perkinsb1024/Block_M_Pin/PCB/Block M.brd

## EAGLE design PCB/Block M.brd (2018-08-06)

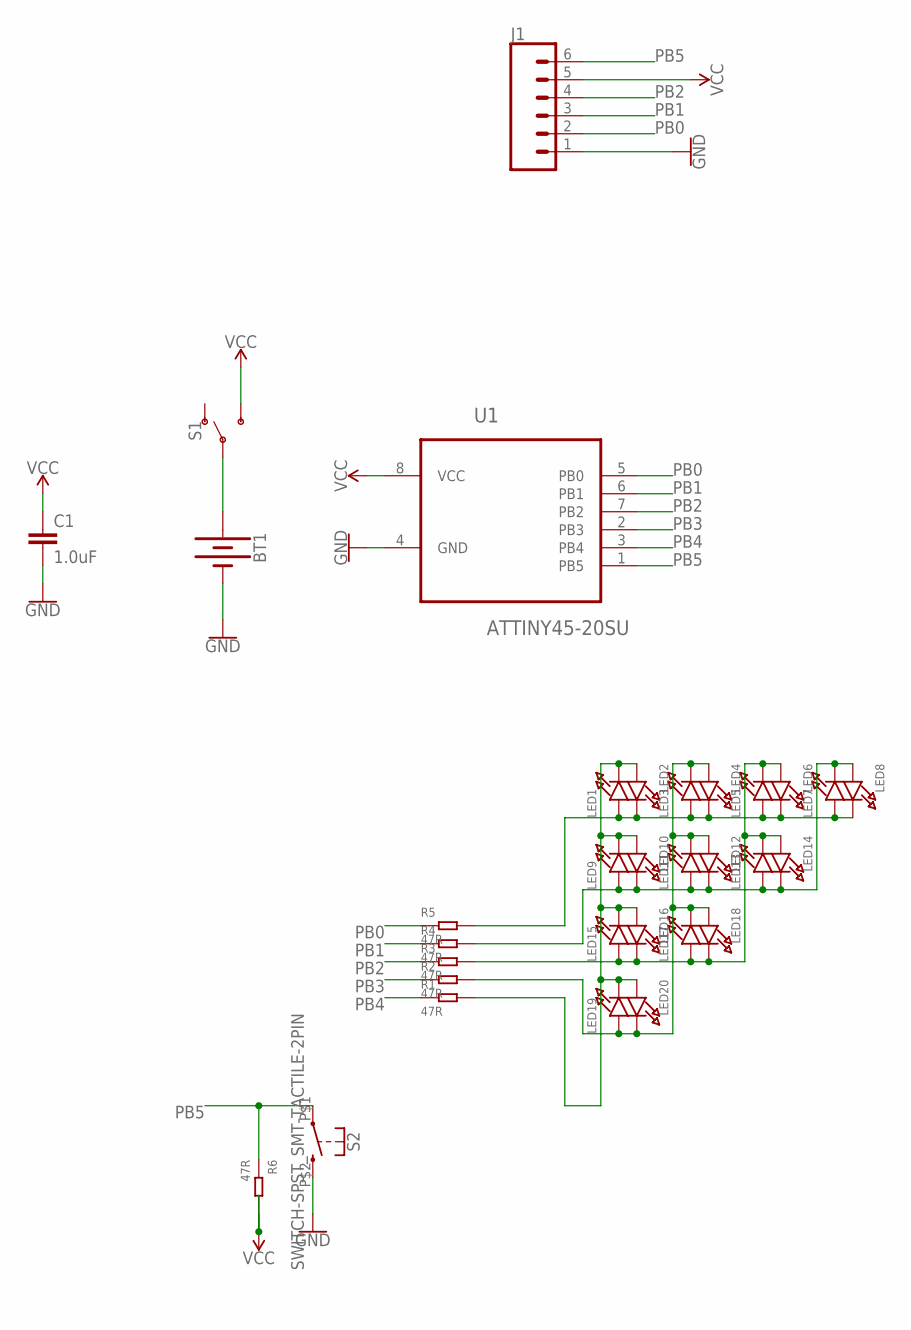
[picture p1: schematic Block M.sch]

Parts:
BT1: BATTERY-12MM_SMD_ALT; BATTCON_12MM_ALT
C1: 1.0uF; 0805
J1: CONN_06SMD-FEMALE-NO-SILK; 1X06-SMD-FEMALE_NO_SILK
LED1, LED2, LED3, LED4, LED5, LED6, LED7, LED8, LED9, LED10, LED11, LED12, LED13, LED14, LED15, LED16, LED17, LED18, LED19, LED20: LED0805_NOOUTLINE; CHIPLED_0805_NOOUTLINE
R1, R2, R3, R4, R5, R6: 47R; R0805
S1: SWITCH-SPDT-SMD-RIGHT-ANGLE; SWITCH_SPST_SMD_A
S2: SWITCH-SPST_SMT-TACTILE-2PIN; SMT_TACTILE_SWITCH_3X2MM
U1: ATTINY45-20SU; SOIC127P798X216-8N

Connections:
GND: BT1.GND (-), C1.2, J1.1, S2.P$2 (2), U1.4 (GND)
unnamed: LED1.A, LED2.C, LED3.A, LED4.C, LED5.A, LED6.C, LED7.A, LED8.C, R5.2
unnamed: BT1.PWR@2 (+), S1.2
unnamed: LED3.C, LED4.A, LED11.C, LED12.A, LED17.C, LED18.A, LED19.A, LED20.C, R2.2
unnamed: LED5.C, LED6.A, LED13.C, LED14.A, LED15.A, LED16.C, LED17.A, LED18.C, R3.2
unnamed: LED1.C, LED2.A, LED9.C, LED10.A, LED15.C, LED16.A, LED19.C, LED20.A, R1.2
unnamed: LED7.C, LED8.A, LED9.A, LED10.C, LED11.A, LED12.C, LED13.A, LED14.C, R4.2
PB0: J1.2, R5.1, U1.5 (PB0)
PB1: J1.3, R4.1, U1.6 (PB1)
PB2: J1.4, R3.1, U1.7 (PB2)
PB3: R2.1, U1.2 (PB3)
PB4: R1.1, U1.3 (PB4)
PB5: J1.6, R6.1, S2.P$1 (1), U1.1 (PB5)
VCC: C1.1, J1.5, R6.2, S1.3 (S), U1.8 (VCC)

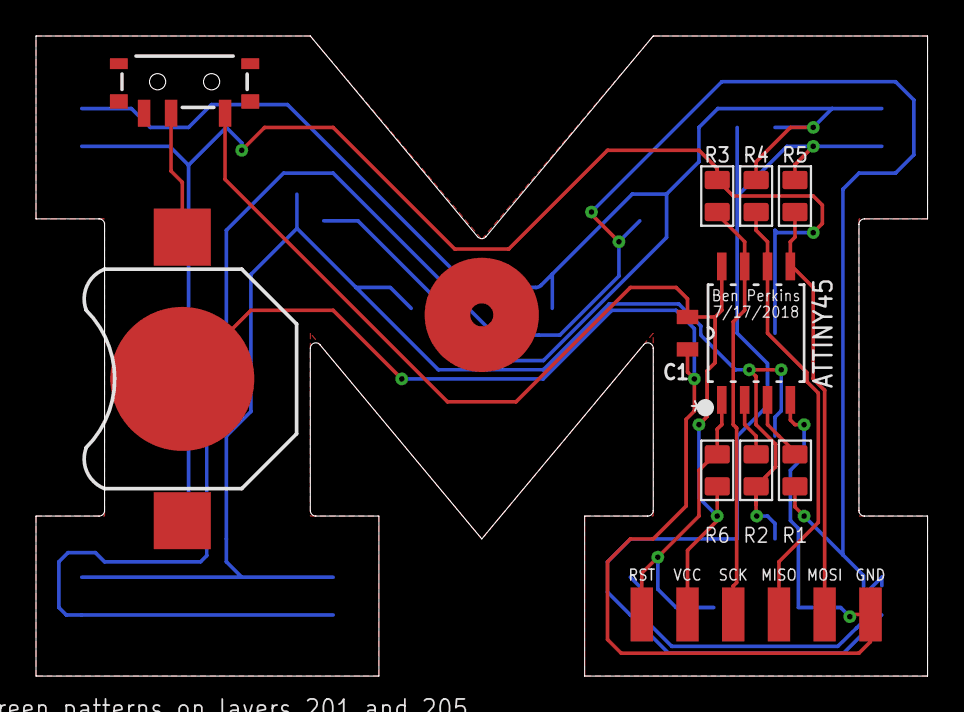
[picture p2: board Block M.brd from above]

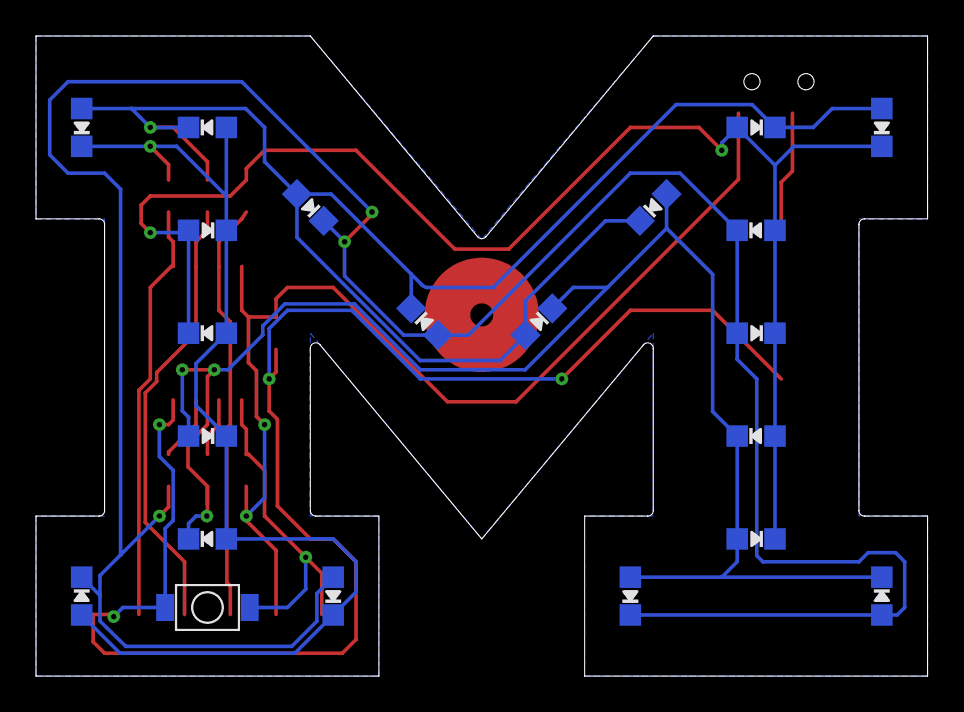
[picture p3: board Block M.brd from below]

Board: 2 copper layers, 49.5 x 35.6 mm, 32 parts (21 on the bottom side), 14 nets.
