perkinsb1024/Block_M_Pin/Block_M/Block_M.ino

// For more information, visit:
// http://bitwise.bperki.com/2018/08/05/block-m-pin-update-2-software-power-and-videos/

// Program configuration
#define USE_EEPROM true

#if USE_EEPROM
#include <EEPROM.h>
#endif

// Limits
#define MAX_DELAY (65535)
#define NUM_LEDS (20)
#define NUM_PATTERNS (7)
#define MIN_RAND_A (96)
#define MAX_RAND_A (138)

// References
#define EEPROM_ADDR_PATTERN (0)
#define EEPROM_ADDR_RAND_A (1)

// Keep track of which pattern to display.
uint8_t patternIndex = 0;
// Keep track of whether the reset reason was the power switch or reset button.
uint8_t buttonPressed = 0;
// This is one of two seed values for the random function.
uint8_t a = MIN_RAND_A;
// This array stores the pin states to light up each LED.
// The high nibble determines which pin number should be high.
// The low nibble defines which pin should be low. All other pins
// should be high impedence (input).
const uint8_t LEDS[] = {
  // High pin - 1 | Low Pin - 1
  0x00 | 0xF, // Bottom left, outer   
  0xF0 | 0x0, // Bottom left, inner
  0x00 | 0x7, // Left straight, 1/5
  0x70 | 0x0, // Left straight, 2/5
  0x00 | 0x3, // Left straight, 3/5
  0x30 | 0x0, // Left straight, 4/5
  0x10 | 0x0, // Top left
  0x00 | 0x1, // Left straight, 5/5
  0x10 | 0xF, // Top left slope
  0xF0 | 0x1, // Bottom left slope
  0x10 | 0x7, // Bottom right slope
  0x70 | 0x1, // Top right slope
  0x30 | 0x1, // Right straight 5/5
  0x10 | 0x3, // Top right
  0x30 | 0xF, // Right straight 4/5
  0xF0 | 0x3, // Right straight 3/5
  0x30 | 0x7, // Right straight 2/5
  0x70 | 0x3, // Right straight 1/5
  0x70 | 0xF, // Bottom right, inner
  0xF0 | 0x7, // Bottom right, outer
  0x00 | 0x0, // No LEDs
}; 

/*
 * Function:  delayCycles 
 * --------------------
 * Delays for a given number of cycles.
 *
 * n: number of cycles to wait.
 */
void delayCycles(uint16_t n) {
  while(n--) {
    asm("nop");
  }
}

/*
 * Function:  pRNG
 * --------------------
 * Generates a "random" number.
 *
 * returns: a somewhat random number.
 */
uint8_t pRNG(void) {
  // https://www.avrfreaks.net/forum/tiny-fast-prng
  // Note: `a` is defined globally, read from EEPROM for improved 'randomness'
  static uint8_t s=0x0F;
  s^=s<<3;
  s^=s>>5;
  s^=a++>>2;
  return s;
}

/*
 * Function:  setLed 
 * --------------------
 * Light a single LED.
 *
 * led: which LED to light (0 to NUM_LEDS-1).
 */
void setLed(uint8_t led) {
  led = LEDS[led];
  uint8_t high = ((led & 0xF0) >> 4) + 1;
  uint8_t low = (led & 0x0F) + 1;
  charlieplex(high, low);
}

/*
 * Function:  charlieplex 
 * --------------------
 * Light a single LED
 *
 * high: the PORTB pin value that should be high.
 * low: the PORTB pin value that should be low.
 */
void charlieplex(uint8_t high, uint8_t low) {
  DDRB = high | low;
  PORTB = high;
}

/*
 * Function:  clearAll 
 * --------------------
 * Turns off all LEDs.
 */
inline void clearAll() {
  DDRB = 0;
  PORTB = 0;
}

/*
 * Function:  drawBitmap
 * --------------------
 * Light LEDs based on a values in a bitmap.
 * Should be called in a loop.
 *
 * bitmap: bit n represents LED n, 1 = on, 0 = off.
 */
void drawBitmap(uint32_t bitmap) {
  // Shift bitmap right one bit at a time to determine if each LED should be on
  for(uint8_t i = 0; i < NUM_LEDS; i++) {
    if(bitmap & 1) {
      // Turn on the current LED
      setLed(i);
    }
    else {
      // Displays nothing, but takes the same amount of time
      // to keep the brightness equal regardless of how many LEDs are on
      setLed(NUM_LEDS);
    }
    // Shift right to get the next pixel
    bitmap = bitmap >> 1;
  }
}

/*
 * Function:  drawBitmapFast
 * --------------------
 * Light LEDs based on a values in a bitmap.
 * Should be called in a loop.
 * Like drawBitmap, but faster. Brightness of LEDs will vary.
 *
 * bitmap: bit n represents LED n, 1 = on, 0 = off.
 */
void drawBitmapFast(uint32_t bitmap) {
  // The brightness of LEDs will change based on how many are lighted
  // Shift bitmap right one bit at a time to determine if each LED should be on
  for(uint8_t i = 0; i < NUM_LEDS; i++) {
    if(bitmap & 1) {
      // Turn on the current LED
      setLed(i);
    }
    // Shift right to get the next pixel
    bitmap = bitmap >> 1;
  }
}

/*
 * Function:  patternSingleBlink
 * --------------------
 * LEDs blink randomly, one at a time.
 * Should be called in a loop.
 */
void patternSingleBlink() {
  uint8_t led = pRNG();
  uint16_t onTime = 8000 + 256 << (pRNG() & 0b111); // 8256 - 40768
  uint16_t offTime = 8000 + 256 << (pRNG() & 0b111); // 8256 - 40768
  // Intentionally allowing overflow by 1 to show no LEDs
  while(led > NUM_LEDS) {
    led -= NUM_LEDS;
  }
  setLed(led);
  delayCycles(onTime);
  clearAll();
  delayCycles(offTime);
}

/*
 * Function:  patternRandomNoise
 * --------------------
 * LEDs blink randomly, up to half of at a time.
 * Should be called in a loop.
 */
void patternRandomNoise() {
  // Only half the LEDs can possibly be on at a time, alternating every cycle.
  // This produces more "motion".
  uint32_t mask = 0x55555555;
  uint32_t oldBitmap = 0;
  uint32_t bitmap = 0;
  for(uint8_t i = 0; i < 255; i++) {
    bitmap = pRNG();
    bitmap <<= 8;
    bitmap |= pRNG();
    bitmap <<= 8;
    bitmap |= pRNG();
    bitmap ^= oldBitmap;
    mask = ~mask;
    for(uint16_t i = 0; i < 250; i++) {
      drawBitmapFast(bitmap & mask);
    }
  }
}

/*
 * Function:  patternFadingBlink
 * --------------------
 * LEDs blink randomly, fading out after turning on.
 * Should be called in a loop.
 */
void patternFadingBlink() {
  const uint8_t BRIGHTNESS_STEPS = 16;
  const uint8_t NUM_REPS = 4;
  const uint8_t NUM_DIFF_DELAYS = 8;
  uint8_t newLed;
  uint8_t leds[NUM_LEDS] = {0};
  uint8_t newLedDelays[NUM_DIFF_DELAYS] = {4, 5, 6, 7, 8, 10, 12, 16};
  uint8_t newLedDelay = newLedDelays[0];
  uint16_t newLedCounter = 0;
  uint8_t delayChanger = 0;
  uint8_t temp;
  while(1) {
    delayChanger = pRNG();
    if(delayChanger == 255) { return; }// Todo: remove
    if(delayChanger == newLedDelay) {
      temp = (pRNG() % NUM_DIFF_DELAYS);
      newLedDelay = newLedDelays[temp];
    }
    for(uint16_t rep = 0; rep < NUM_REPS; rep++) {
      newLedCounter++;
      if(newLedCounter >= newLedDelay) {
        newLedCounter = 0;
        newLed = pRNG() % 32;
        if(newLed < NUM_LEDS && leds[newLed] == 0) { 
          leds[newLed] = BRIGHTNESS_STEPS;
        }
      }
      for(uint8_t brightness = 0; brightness < BRIGHTNESS_STEPS; brightness++) {
        for(uint8_t led = 0; led < NUM_LEDS; led++) {
          if(leds[led] > 0) {
            if(leds[led] > brightness) { setLed(led); }
            else { clearAll(); }
          }
        }
      }
    }
    for(uint8_t led = 0; led < NUM_LEDS; led++) {
      if(leds[led] > 0) {
        leds[led]--;
      }
    }
  }
}

/*
 * Function:  patternBoomIn
 * --------------------
 * Like a VU/Volume Meter.
 * Should be called in a loop followed by patternBoomOut.
 * 
 * leds: array of uint8_t of size NUM_LEDS, init with 0 outside of loop.
 */
void patternBoomIn(uint8_t* leds) {
  const uint8_t BRIGHTNESS_STEPS = 32;
  const uint8_t BRIGHTNESS_STEP = 17;
  const uint8_t NUM_REPS = 1 + (pRNG() & 1);
  const uint8_t MAX_STAGES = 10;
  uint8_t centerStages[NUM_LEDS] = {10, 4, 8, 6, 4, 6, 10, 8, 4, 1, 1, 4, 8, 10, 6, 4, 6, 8, 4, 10};
  uint8_t chaseStages[NUM_LEDS] = {8, 8, 7, 6, 5, 4, 4, 3, 2, 1, 1, 2, 3, 4, 4, 5, 6, 7, 8, 8};
  uint8_t verticalStages[NUM_LEDS] = {1, 1, 2, 3, 4, 5, 6, 6, 5, 4, 4, 5, 6, 6, 5, 4, 3, 2, 1, 1};
  uint8_t stage = 0;
  uint8_t offDelay = 0;
  bool done = false;
  bool doneEarly = false;
  while(!(done || doneEarly)) {
    // Light the LEDs proportional to the value at leds[i].
    for(uint16_t rep = 0; rep < NUM_REPS; rep++) {
      for(uint8_t brightness = 0; brightness < BRIGHTNESS_STEPS; brightness++) {
        for(uint8_t led = 0; led < NUM_LEDS; led++) {
            if(leds[led] > brightness) { setLed(led); }
            else { clearAll(); }
        }
      }
    }
    // Adjust brightness of each led.
    done = true;
    if(stage < MAX_STAGES) { stage++; }
    for(uint8_t led = 0; led < NUM_LEDS; led++) {
      if(leds[led] < BRIGHTNESS_STEPS) {
        if(stage >= verticalStages[led]) {
          leds[led] += 8;
        }
        done = false;
      }
      else {
        leds[led] = BRIGHTNESS_STEPS;
      }
    }
    if(pRNG() < 20) { doneEarly = true; }
  }
}

/*
 * Function:  patternBoomOut
 * --------------------
 * Like a VU/Volume Meter.
 * Should be called in a loop preceded by patternBoomIn.
 * 
 * leds: array of uint8_t of size NUM_LEDS, same array
 *       as passed into patternBoomIn.
 */
void patternBoomOut(uint8_t* leds) {
  const uint8_t BRIGHTNESS_STEPS = 32;
  const uint8_t NUM_REPS = 2;
  uint8_t centerFade[NUM_LEDS] = {8, 4, 7, 6, 3, 6, 8, 7, 2, 1, 1, 2, 7, 8, 6, 3, 6, 7, 4, 8};
  uint8_t chaseFade[NUM_LEDS] = {8, 8, 7, 6, 5, 4, 4, 3, 2, 1, 1, 2, 3, 4, 4, 5, 6, 7, 8, 8};
//  uint8_t verticalFade[NUM_LEDS] = {1, 1, 2, 3, 4, 5, 6, 6, 5, 4, 4, 5, 6, 6, 5, 4, 3, 2, 1, 1};
  uint8_t verticalFade[NUM_LEDS] = {2, 2, 4, 6, 8, 10, 12, 12, 10, 8, 8, 10, 12, 12, 10, 8, 6, 4, 2, 2};
  uint8_t offDelay = 0;
  bool done = false;
  bool doneEarly = false;
  for(uint8_t led = 0; led < NUM_LEDS; led++) {
    leds[led] = BRIGHTNESS_STEPS;
  }
  while(!(done || doneEarly)) {
    // Light the LEDs proportional to the value at leds[i].
    for(uint16_t rep = 0; rep < NUM_REPS; rep++) {
      for(uint8_t brightness = 0; brightness < BRIGHTNESS_STEPS; brightness++) {
        for(uint8_t led = 0; led < NUM_LEDS; led++) {
            if(leds[led] > brightness) { setLed(led); }
            else { clearAll(); }
        }
      }
    }
    // Adjust brightness of each led
    done = true;
    for(uint8_t led = 0; led < NUM_LEDS; led++) {
      if(leds[led] > verticalFade[led]) {
        leds[led] -= verticalFade[led];
        done = false;
      }
      else {
        leds[led] = 0;
      }
    }
    if(pRNG() < 24) { doneEarly = true; }
  }
  if(done) {
    clearAll();
    offDelay = pRNG();
    if(offDelay & 1) {
      while(offDelay > 0) {
        delayCycles(150);
        offDelay--;
      }
    }
  }
}

/*
 * Function:  patternLoop
 * --------------------
 * LEDs fill up one at a time before unfilling one at a time.
 * Should be called in a loop.
 */
void patternLoop() {
  uint32_t bitmap = 0;
  for(uint8_t j = 0; j <= NUM_LEDS * 2; j++) {
    for(uint16_t i = 0; i < 50; i++) {
      drawBitmap(bitmap);
    }
    bitmap = bitmap << 1;
    if(j <= NUM_LEDS) {
      bitmap |= 1;
    }
  }
}

/*
 * Function:  patternFade
 * --------------------
 * LEDs fade in and then fade out.
 * Should be called in a loop.
 */
void patternFade() {
  const uint8_t BRIGHTNESS_RANGE = 48;
  uint8_t brightnessStep = 1;
  uint8_t ledBrightness = 0;
  uint8_t reps = 0;
  bool done = false;
  bool fadeIn = true;
  while(!done) {
    brightnessStep = 3;
    reps = 2;
    if(ledBrightness < 4) {
      reps = 5;
      brightnessStep = 1;
    }
    else if(ledBrightness < 8) {
      reps = 4;
      brightnessStep = 2;
    }
    else if(ledBrightness < 12) {
      reps = 3;
    }
    // Light the LEDs proportional to the value at leds[i].
    for(uint16_t rep = 0; rep < reps; rep++) {
      for(uint8_t brightness = 0; brightness < BRIGHTNESS_RANGE; brightness++) {
        for(uint8_t led = 0; led < NUM_LEDS; led++) {
            if(ledBrightness > brightness) { setLed(led); }
            else { clearAll(); }
        }
      }
    }
    // Adjust the current brightness.
    if(fadeIn) {
      if(ledBrightness < BRIGHTNESS_RANGE) {
        ledBrightness += brightnessStep;
      }
      else {
        ledBrightness = BRIGHTNESS_RANGE;
      }
    }
    else {
      if(ledBrightness >= brightnessStep) {
        ledBrightness -= brightnessStep;
      }
      else {
        ledBrightness = 0;
      }
    }
    if(fadeIn && ledBrightness == BRIGHTNESS_RANGE) {
      fadeIn = false;
    }
    else if(!fadeIn && ledBrightness == 0) {
      done = true;
    }
  }
  delayCycles(15000);
}

/*
 * Function:  patternFlash
 * --------------------
 * LEDs blink on and off all together.
 * Should be called in a loop.
 */
void patternFlash() {
  uint32_t onBitmap = 0xFFFFFFFF;
  uint32_t offBitmap = 0x00000000;
  for(uint16_t i = 0; i < 512; i++) {
    if(i < 255) {
      drawBitmap(onBitmap);
    }
    else {
      drawBitmap(offBitmap);
    }
  }
}

/*
 * Function:  patternWipe
 * --------------------
 * LEDs fill in from the left, then unfill to the right.
 * It looks like they're wiping across from left to right.
 * Should be called in a loop.
 */
void patternWipe() {
  uint32_t rows[] = {
    0x00000041,
    0x000000BC,
    0x00000102,
    0x00000200,
    0x00000400,
    0x00040800,
    0x0003D000,
    0x00082000,
  };
  uint32_t pattern = 0;
  for(uint8_t i = 0; i < 18; i++) {
    for(uint8_t j = 0; j < 64; j++) {
      drawBitmap(pattern);
    }
    if(i < 8) {
      pattern |= rows[i];
    }
    else if(i < 16) {
      pattern &= ~rows[i-8];
    }
  }
}

/*
 * Function:  patternChase
 * --------------------
 * Theater-Chase effect, LEDs chase each other.
 * Should be called in a loop.
 */
void patternChase() {
  uint8_t SPACING = 5;
  const uint8_t BRIGHTNESS_RANGE = 16;
  const uint8_t LED_BRIGHTNESS = 10;
  uint8_t reps = 64;
  for(uint8_t startIndex = 0; startIndex < SPACING; startIndex++) {
    for(uint16_t rep = 0; rep < reps; rep++) {
      for(uint8_t brightness = 0; brightness < BRIGHTNESS_RANGE; brightness++) {
        for(uint8_t led = startIndex; led < NUM_LEDS; led+=SPACING) {
            if(LED_BRIGHTNESS > brightness) { setLed(led); }
            else { clearAll(); }
        }
      }
    }
  }
}

void setup() {
  // Determine if we should update the random seed 'a'.
  bool updateA = false;
  // Determine if the button was pressed (external reset).
  if(MCUSR & (1 << EXTRF)) {
    buttonPressed = 1;
  }
  // Reset the status register.
  MCUSR = 0;
#if USE_EEPROM
  // Read the saved pattern index and random seed 'a'.
  patternIndex = EEPROM.read(EEPROM_ADDR_PATTERN);
  a = EEPROM.read(EEPROM_ADDR_RAND_A);
  // If the button was pressed, increment pattern.
  if(buttonPressed || patternIndex >= NUM_PATTERNS) {
    patternIndex += 1;
    // If we exceeded the number of available patterns...
    if(patternIndex >= NUM_PATTERNS) {
      patternIndex = 0;
      // Increment random seed
      a++;
      updateA = true;
    }
    EEPROM.write(EEPROM_ADDR_PATTERN, patternIndex);
  }
  // Make sure 'a' stays in the acceptable range.
  if(a > MAX_RAND_A || a < MIN_RAND_A) {
    a = MIN_RAND_A;
    updateA = true;
  }
  if(updateA) {
    EEPROM.write(EEPROM_ADDR_RAND_A, a);
  }
#else
  patternIndex = 0;
#endif
  // Power saving functions.
  ACSR |= _BV(ACD); // Disable ADC.
  ADCSRA &= ~_BV(ADEN); // Disable ADC.
  // Unlock watchdog to allow changes (see datasheet section 8.5.2).
  WDTCR |= (_BV(WDCE) | _BV(WDE));
  // Disable watchdog.
  WDTCR &= ~_BV(WDE);
  WDTCR &= ~_BV(WDIE);
  // Shut down all timers (none are used).
  PRR |= _BV(PRTIM0) | _BV(PRTIM1) | _BV(PRUSI) | _BV(PRADC);
}

void loop() {
  static uint8_t leds[NUM_LEDS] = {0};
  switch(patternIndex) {
    case 0:
      patternFadingBlink();
      break;
    case 1:
      patternChase();
      break;
    case 2:
      patternLoop();
      break;
    case 3:
      patternWipe();
      break;
    case 4:
      patternFlash();
      break;
    case 5:
      patternFade();
      break;
    case 6:
      patternBoomIn(leds);
      patternBoomOut(leds);
      break;
    default:
      delayCycles(MAX_DELAY);
      break;
  }
}
