perkinsb1024/Block_M_Pin/(commit log)

2018-07-30 Added more patterns and reduced MCU power consumption
2018-08-06 Added PCB files (Eagle and Gerber)
    [Block M.brd, Block M.sch]
2018-08-06 Move Arduino Sketch into folder with the same name
